Yoan-Veron/Arduino_peip2/README.md

Projet Arduino - 2023/2024
Veron Yoan et Bouslih Adil - Groupe 3

#Idée principale : 
Créer un robot laveur de table

#Structure : regarder le fichier plan.

#Fonctionnement :

Etape 1) Un robot qui parcours toute la table, sans tomber.

Etape 2) Ajout des brosses pour nettoyer.

Etape 3) Ajout d'un dispositif qui dépose du produit.

Etape final, le robot fait un premier tour pour balayer la table et repérer le chemin. Puis il fait un second tour pour déposer le produit nettoyant. Une fois finit, il envoie un message à l'utilisateur, et/ou fais un son pour dire qu'il a terminé.

#Matériel :
2 roues
4 moteurs (2roues et 2brosses)
2 capteurs de profondeurs
1 carte moteur
2 brosses
1 reservoir
1 socle
Cotons
