Yoan-Veron/Arduino_peip2/Rapport séance/Yoan/Séance 8/Séance 8.pdf

# Yodilus

Lors de cette dernière séance, j’ai découpé le bas d’une raclette et 2 tassos que j’ai fixé sous le robot

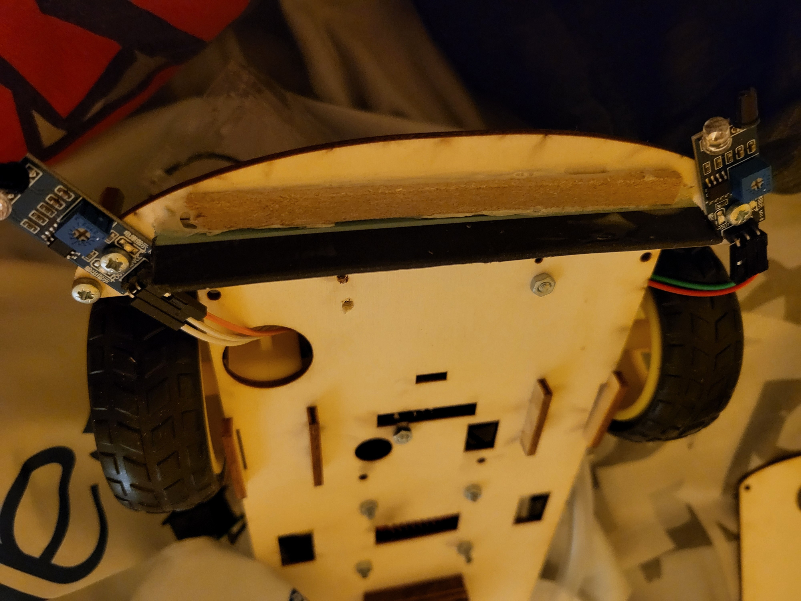
[picture p1: figure]

Ensuite, je me suis penché avec Adil sur l’utilisation de notre pompe avec un interrupteur et son alimentation.

Nous avons ensuite relié tous les éléments entre eux et effectué nos dernier tests.

Il ne reste plus qu’a fixer les dernier composants.
