Yoan-Veron/Arduino_peip2/Rapport séance/Adil/Séance 8/Compte Rendu TP8.pdf

## Rapport Séance 8 – Le Yodilus

Cette dernière séance a été dédié au perfectionnement du projet, en y assemblant notamment l’ensembles des composants et matériels nécessaires au fonctionnement du Yodilus (pompe, interrupteur, réservoir …) . Il a donc fallu démonter la voiture pour faire en sorte d’avoir un câblage propre et en mettant les composants utiles pour la voiture de la manière la plus esthétique.

Yoan de son coté a pu mettre en place le bout noir de la raclette que j’ai apporter sur l’avant du véhicule avec de la colle.

La pompe fonctionne comme il le faut, néanmoins comme énoncé au début du rapport du recâblage a été nécessaire, afin de donner un aspect plus agréable d’une part, mais aussi de fixer les câbles correctement afin que ces derniers ne se débranchent pas et ainsi engendrent un court-circuit, signant la fin de notre projet.

J’ai donc dû effectuer de la soudure en rajoutant notamment un interrupteur pour la pompe à eau :

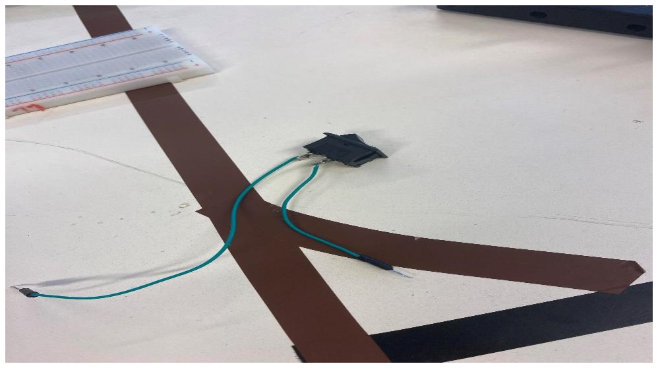
[picture p2: figure]
