Yoan-Veron/Arduino_peip2/Planning.pdf

### YODILUS PLANNING

1 | 2 | 3 | 4 | 5 | 6 | 7 | 8

BROSSE

ROUE + CAPTEUR

POMPE

CHASSIS

CODE + MONTAGE

CODE + MONTAGE

CODE + MONTAGE

PLAN + MONTAGE

Répartition :
-Yoan + présent sur la partie plan + montage/fonctionnement -Adil + présent pour la partie code + montage/fonctionnement
