Yoan-Veron/Arduino_peip2/Rapport séance/Yoan/Séance 6/Seance6.pdf

# Yodilus

Pour commencer cette séance, j’ai continué le 2nd réservoir en Plexiglas puisque le 1er a été dérobé lors de la séance précédente... (colle acrylique + troue pour la pompe).

J’ai ensuite intégré les capteurs au montage final, puis j’ai implémenté le code des capteurs dans le code final :

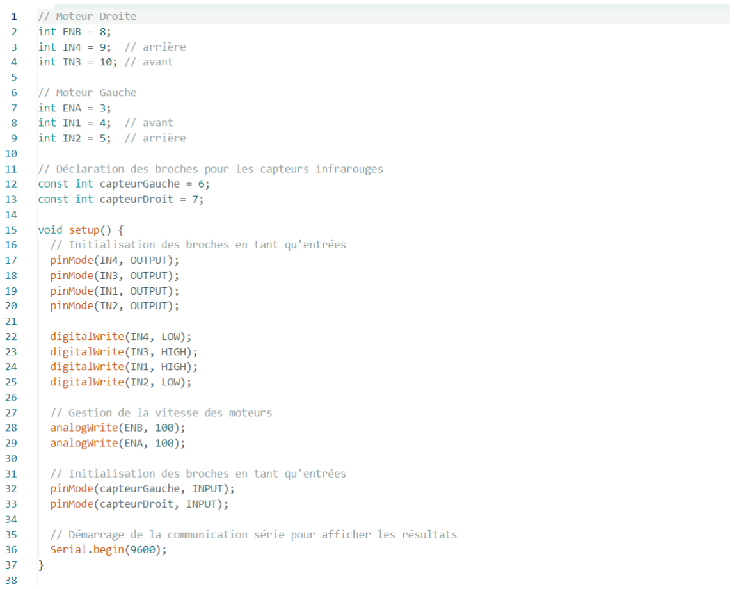
[picture p14: figure]

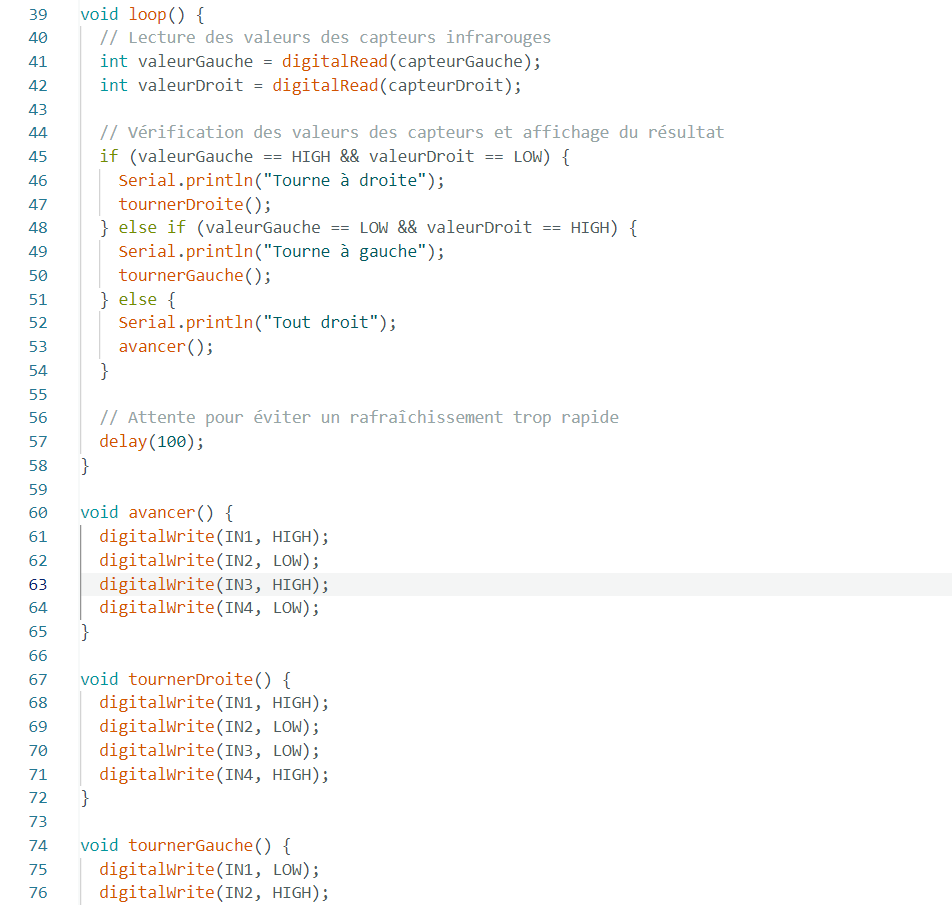
[picture p15: figure]

Pour pouvoir effectuer les premiers vrais tests, j’ai du visser certains composants au chassis, sauf qu’il n’y avait plus de vis de la bonne taille. J’ai donc du couper les vis avec une pince. Cependant la première vis que l’on m’a donné était en inox... Après avoir changé de matériau, j’ai du limer le bout de la vis pour faire en sorte de pouvoir mettre un écrou en bout de vis.

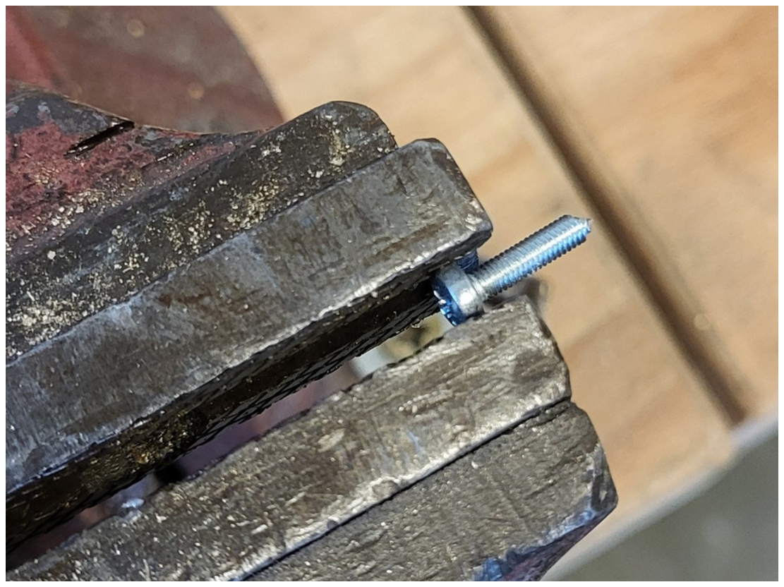
[picture p16: figure]

Une fois le réarrangement fait sur le montage final, j’ai commencé la phase de test qui consiste à faire rouler le robot très doucement sur la table, sans qu’il sorte de la table/ cercle en scotch marron, puisqu’il n’y avait plus de scotch noir. Test pas très concluant, surtout que la fin du test a été initié par un arrêt total des moteurs du robot...
