Yoan-Veron/Arduino_peip2/Rapport séance/Yoan/Séance 3/Seance3.pdf

# Yodilus

Mon objectif dans cette séance a été de m’occuper des moteurs/roues (enfin!).

Mais avant tout, un peu de soudure... Nous avons enfin tous nos moteurs qui fonctionnent.

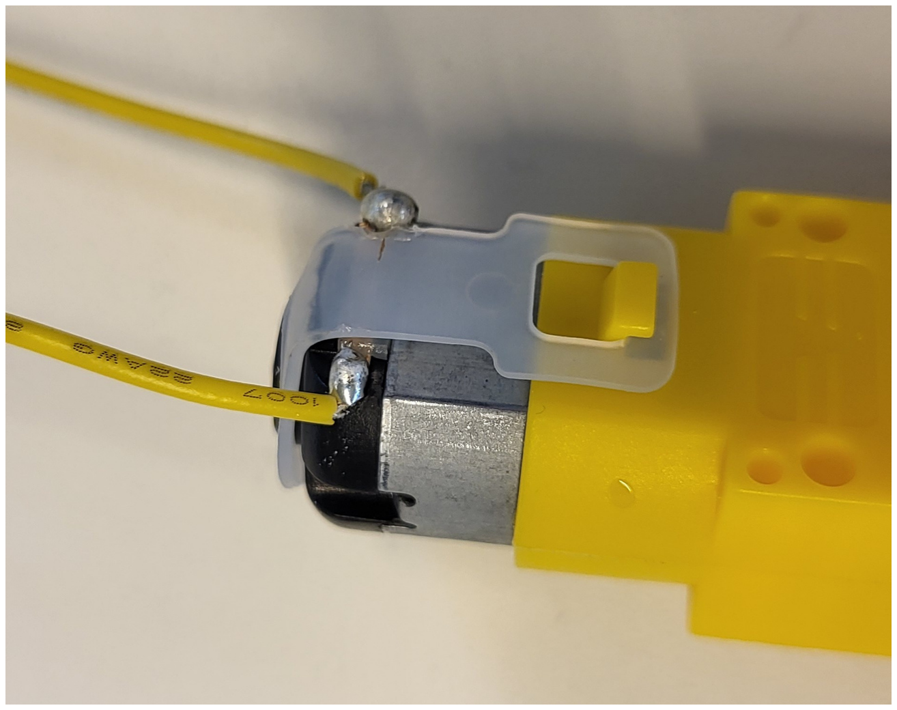
[picture p18: figure]

J’ai réalisé le montage des moteurs avec un pont en H, en notant le numéro des pins utilisés dans le programme.

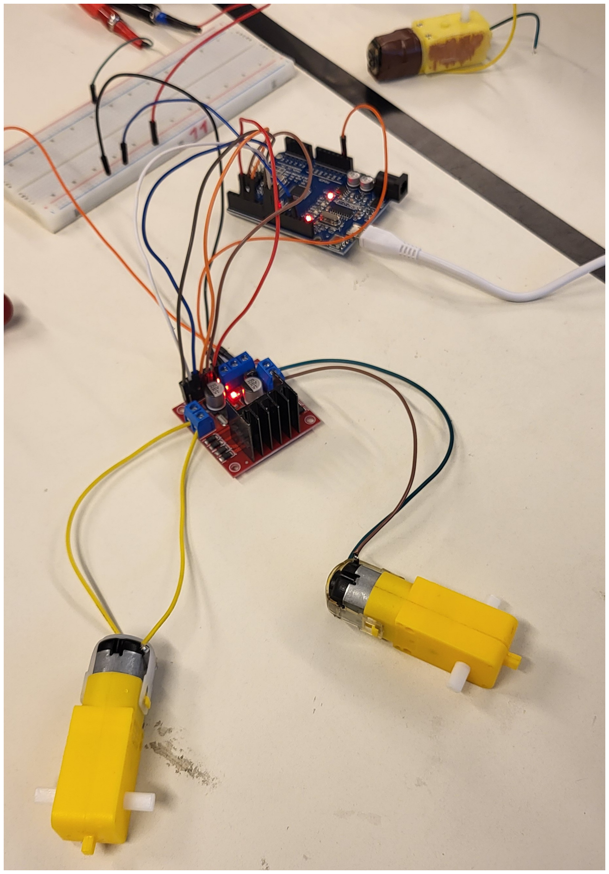
[picture p19: figure]

Ensuite je l’ai incorporé au chassis, on nous a fournit des piles de li-ions qui seront prochainement ajoutées au montage.

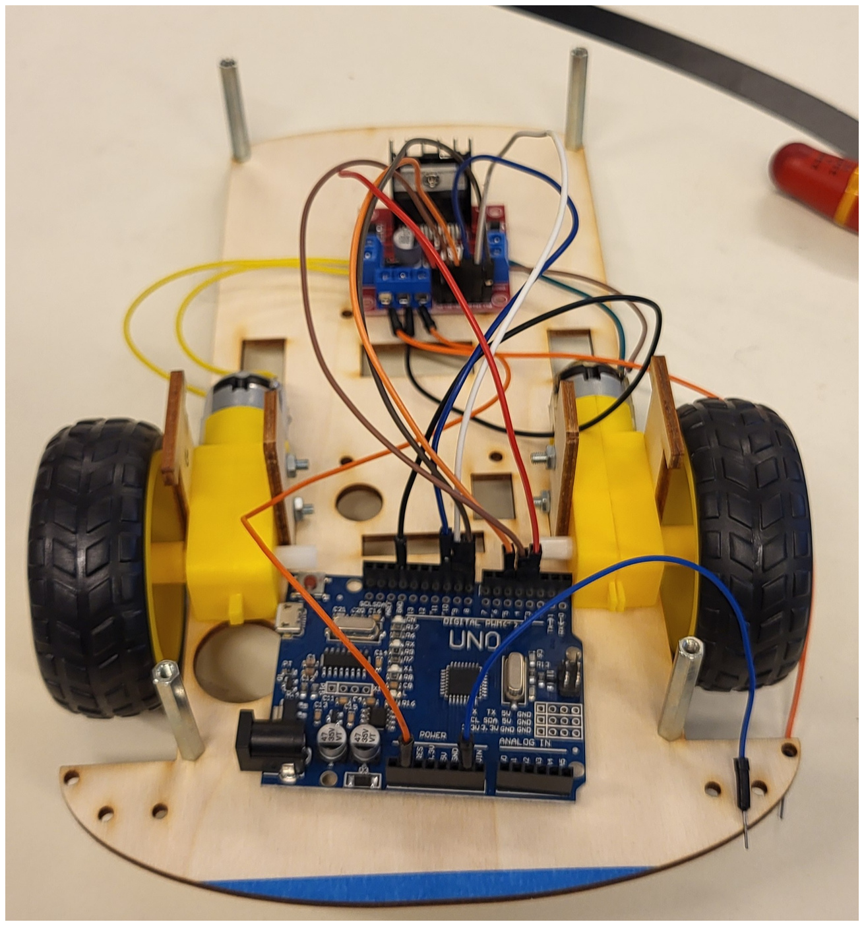
[picture p20: figure]
