Yoan-Veron/Arduino_peip2/Rapport séance/Yoan/Séance 2/Seance2_Yoan.pdf

# Yodilus

Mon objectif dans cette séance a été de commencer le montage de notre voiture comme vous pouvez le voir ci-dessous.

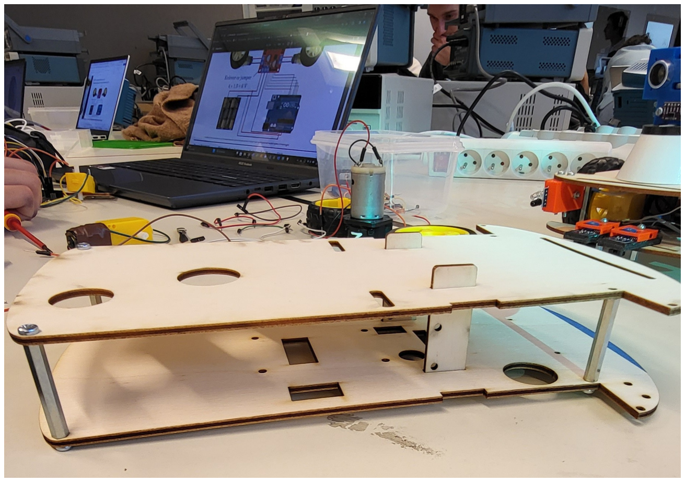
[picture p22: figure]

Après j’ai aidé Adil avec le fonctionnement des moteurs, nous avons rencontré des problèmes avec deux moteurs, l’un avait les balais à l’intérieur complètement pliés et l’autre n’en avait tout simplement plus. Ensuite nous avons rencontré des problèmes de communication entre la carte Arduino et l’ordinateur (problème réglé). Nous avons également rencontré un problème avec le pont en H, on pouvait constater une très grosse perte de puissance lors de l’utilisation des moteurs.

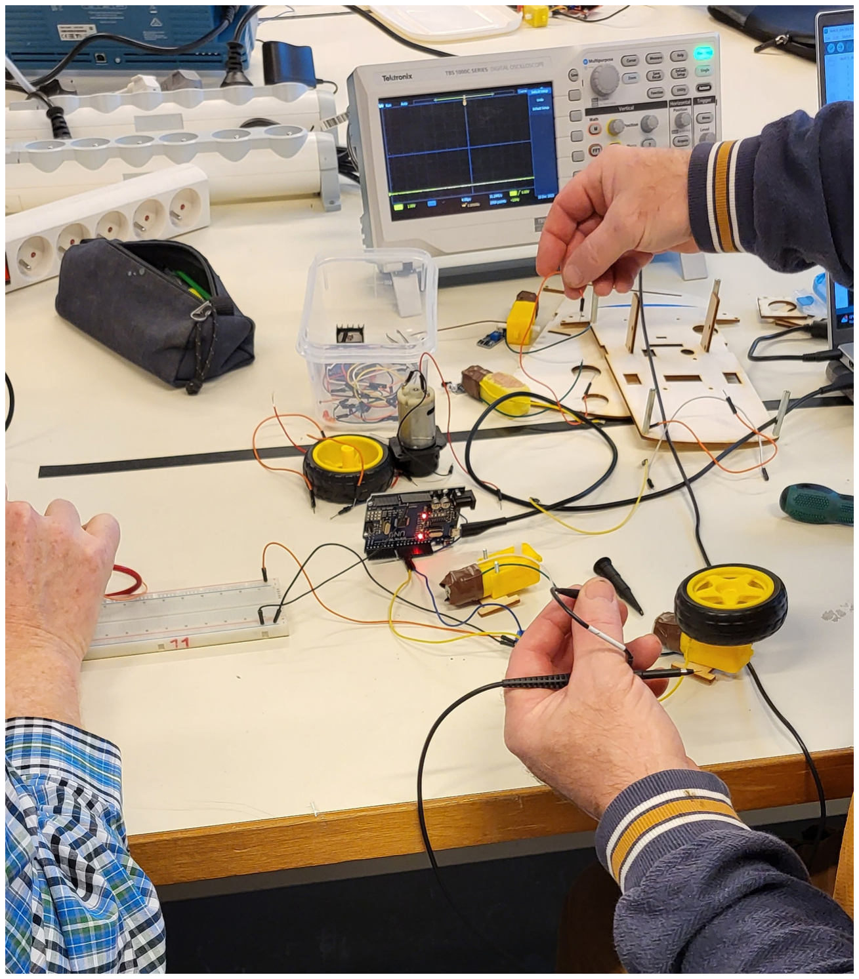
[picture p23: figure]

Ce problème a donné du fil à retordre à nos professeur qui ont essayé de nous aider, nous avons utiliser les jumpers, pour essayer de régler le problème (en vain).

Nous avons perdu pas mal de temps sur cette séance, comme pour la première, mais normalement tout devrait bien se dérouler lors de la prochaine séance.
