Yoan-Veron/Arduino_peip2/Rapport séance/Yoan/Séance 1/Seance1_Yoan.pdf

# Yodilus

Dans cette séance nous avons découvert les éléments que nous pouvons utiliser pour créer notre robot. Nous avons du faire de la soudure pour soudre les fils de nos moteurs abimés.

Dans cette séance, mon but a été de faire le croquis de notre projet sous différentes vues

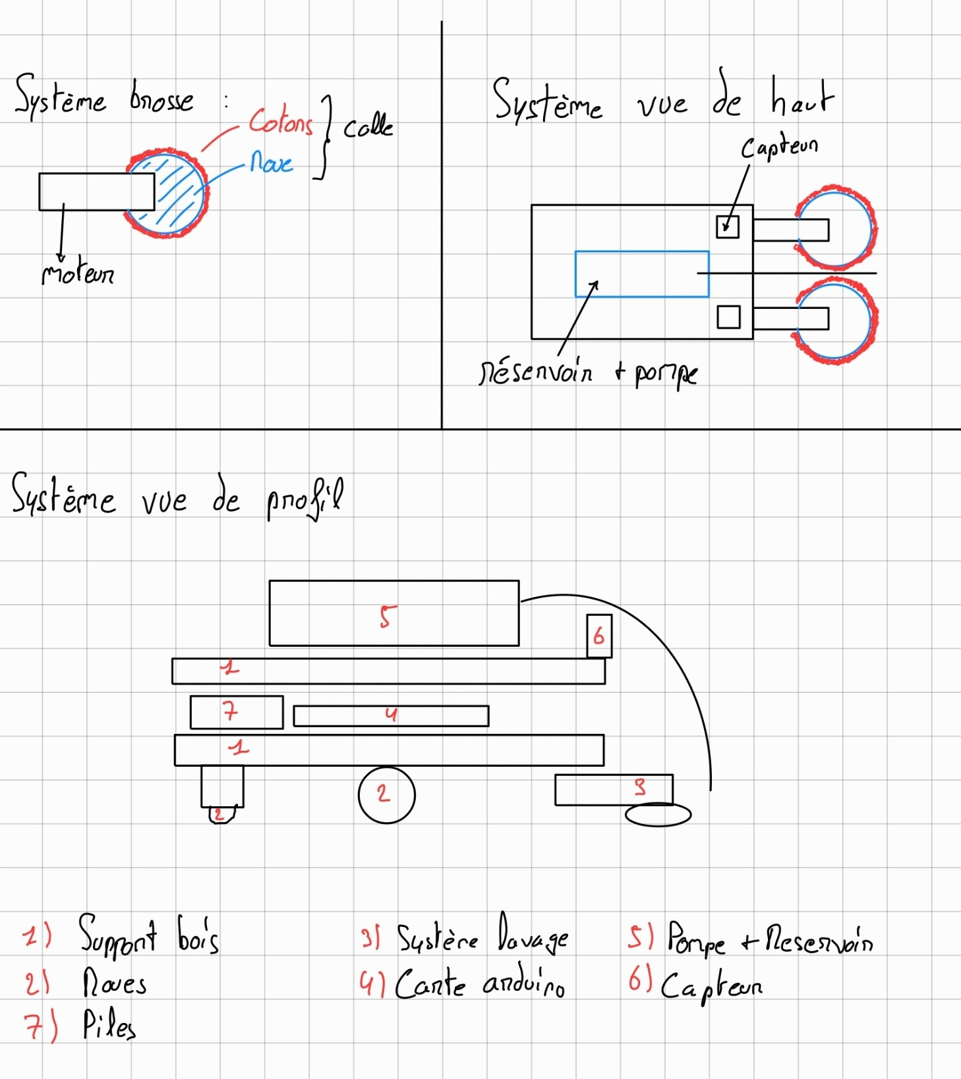
[picture p24: figure]

Grace à cela nous avons pu déterminer le type de chassis dont nous avons besoin.

Nous devrions l’avoir lors de la séance 2 dans laquelle nous ferons le début du montage et du code.
