Yoan-Veron/Arduino_peip2/Le Yodilus.pdf

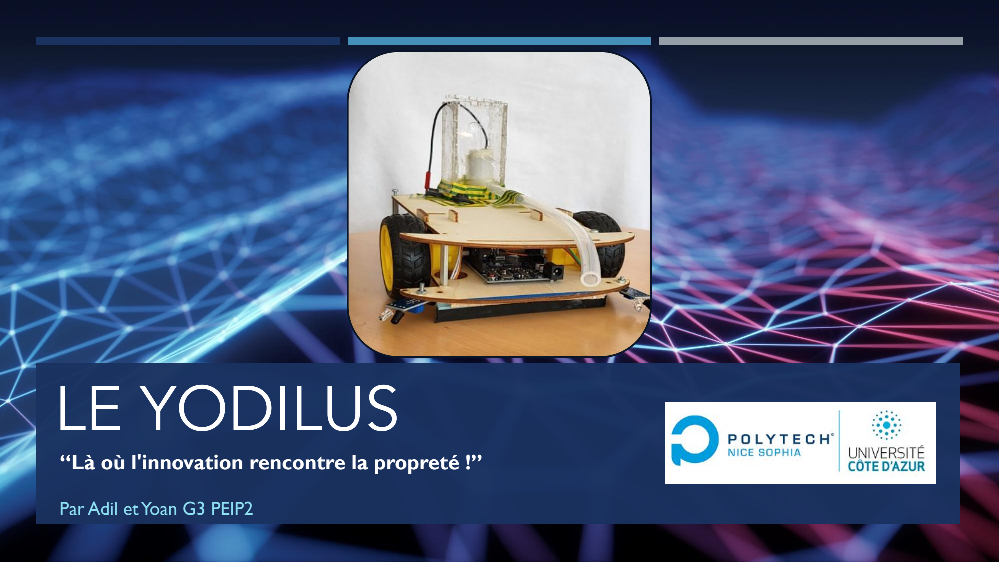
[picture p25: page 1]

# LE YODILUS

Par Adil et Yoan G3 PEIP2

“Là où l'innovation rencontre la propreté !”

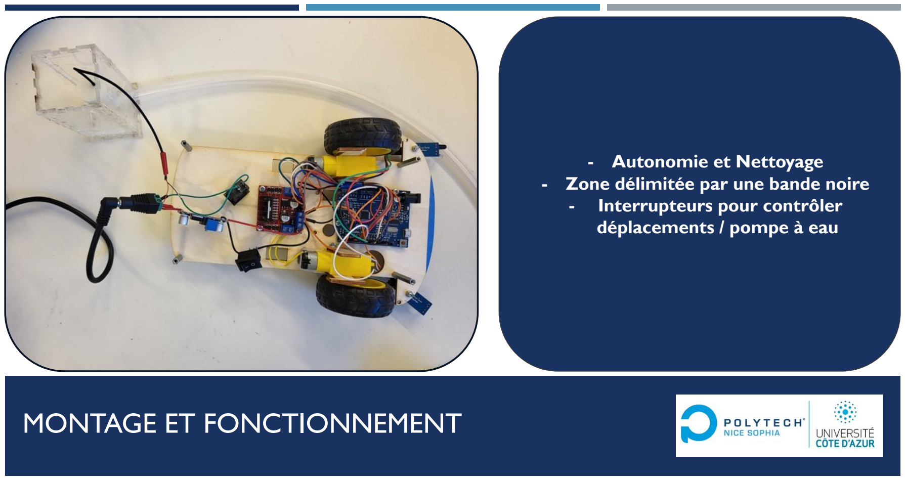
[picture p26: page 2]

## MONTAGE ET FONCTIONNEMENT

- Autonomie et Nettoyage
- Zone délimitée par une bande noire
- Interrupteurs pour contrôler déplacements / pompe à eau

## NOS VALEURS

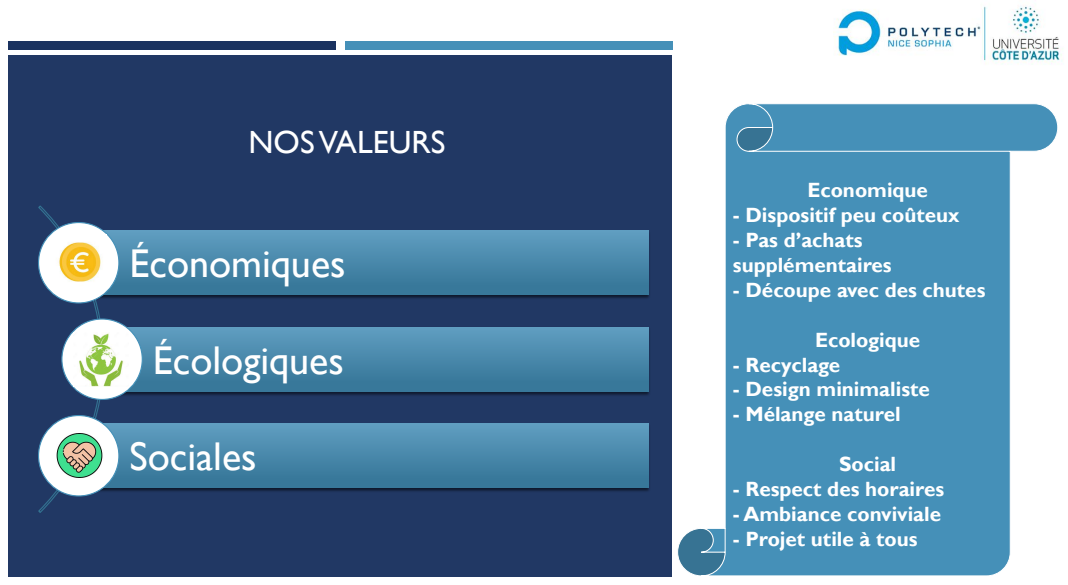
[picture p27: page 3]
Économiques; Écologiques; Sociales; Economique; Ecologique - Recyclage - Design minimaliste - Mélange naturel; Social

- Dispositif peu coûteux
- Pas d’achats
supplémentaires
- Découpe avec des chutes

- Respect des horaires
- Ambiance conviviale
- Projet utile à tous

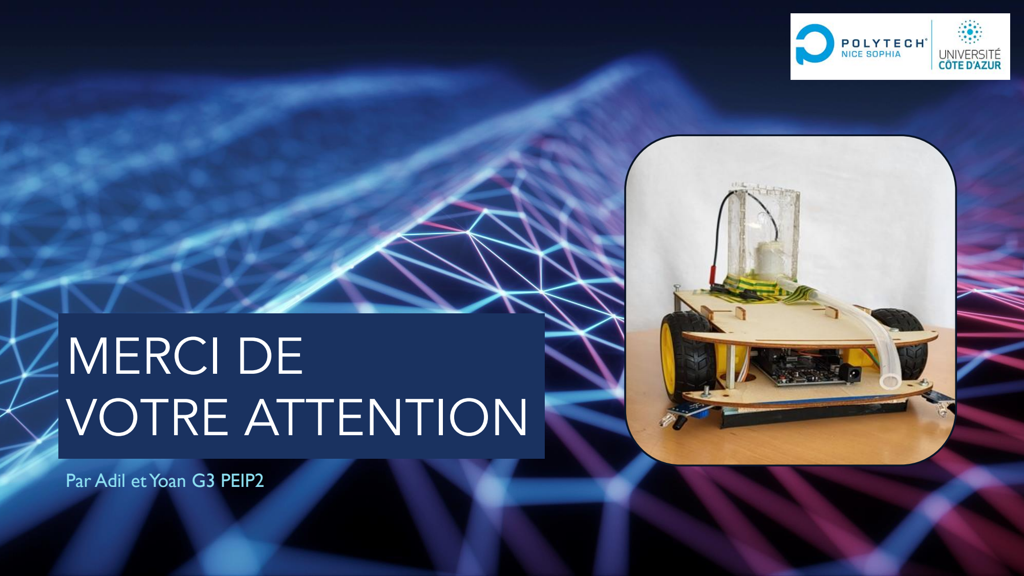
[picture p28: page 4]

Par Adil et Yoan G3 PEIP2

# MERCI DE VOTRE ATTENTION
